Harry-Qu/drone/Doc/飞行状态转换.md

飞行状态转换

| | STOP-INIT | STOP-MANUAL_CALIBRATION |  STOP-READY  |
| --- | :---: | :---: | :---: |
| STOP-INIT | / | (自检异常) \|\| (S1=UP && S2=DOWN) | 完成自检 |
| STOP-MANUAL_CALIBRATION | / | / | 人工校准完成 |
| STOP-READY | / | S1=UP && S2=DOWN | / |
| RUNNING-READY | / | / | S1=UP |
| RUNNING-IDLE | / | / | S1=UP |
| RUNNING-HOVER | / | / | S1=UP |
| RUNNING-MOVING | / | / | S1=UP |

| | RUNNING-READY | RUNNING-IDLE | RUNNING-HOVER | RUNNING-MOVING |
| --- | --- | --- | --- | --- |
| STOP-INIT | / | / | / | / |
| STOP-MANUAL_CALIBRATION | / | / | / | / |
| STOP-READY | S1 = DOWN | / | / | / |
| RUNNING-READY | / | 内八拨杆 | / | / |
| RUNNING-IDLE | / | / | / | 油门向上 |
| RUNNING-HOVER | / | / | / | 拨杆 |
| RUNNING-MOVING | / | / | 摇杆回中 | / |
