Harry-Qu/drone/Code/Core/Src/main.c

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
/* Includes ------------------------------------------------------------------*/
#include "main.h"
#include "dma.h"
#include "i2c.h"
#include "tim.h"
#include "usart.h"
#include "gpio.h"

/* USER CODE BEGIN Includes */
#include "ucos_ii.h"
#include "app_manage.h"
#include "sdk_time.h"
#include "sdk_ano.h"
#include "sdk_i2c.h"
#include "sdk_usart.h"

/* USER CODE END Includes */


void SystemClock_Config(void);
/**
  * @brief  The application entry point.
  * @retval int
  */
int main(void) {
    /* MCU Configuration--------------------------------------------------------*/

    /* Reset of all peripherals, Initializes the Flash interface and the Systick. */
    HAL_Init();

    /* Configure the system clock */
    SystemClock_Config();

    /* Initialize all configured peripherals */
    MX_GPIO_Init();
    MX_DMA_Init();
    MX_USART1_UART_Init();
    MX_TIM3_Init();
    MX_I2C1_Init();
    MX_USART2_UART_Init();
    MX_USART6_UART_Init();
    MX_TIM10_Init();
    MX_I2C3_Init();
    /* USER CODE BEGIN 2 */

    sdk_io_init(FD_UART);
    HAL_Delay(1);


//    app_bluetooth_init();

//    app_oled_Show_Template();

    OS_TRACE_INIT();
    OS_TRACE_START();
    OSInit();

    sdk_i2c_dma_init();
    sdk_usartdma_init();

    app_init();
    app_create_task();


    OSStart();

    /* USER CODE END 2 */

    /* Infinite loop */
    /* USER CODE BEGIN WHILE */

    while (1) {
        /* USER CODE END WHILE */

        /* USER CODE BEGIN 3 */
    }
    /* USER CODE END 3 */
}

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
