Harry-Qu/drone/Code/App/Inc/app_control.h

/** 
 *  @brief	    控制相关任务
 *  @details    提供控制相关任务，包含对遥控器数据解算，计算期望角度，PID计算，动能分配，输出PWM
 *  @author     Harry-Qu
 *  @date       2022/10/28
 *  @version    1.1
 *  @par        日志
 *                  1.0.0   |   实现基本控制功能
 *                  1.0.1   |   新增限制最大转速功能
 *                  1.0.2   |   修改电机转速测试代码中满油门值为限制最大转速值
 *                  1.1     |   新增数据互斥访问功能
*/

#include "main.h"
#include "pid.h"
#include "driver_motor.h"

#ifndef APP_CONTROL_H
#define APP_CONTROL_H

#define MOTOR_FL 2
#define MOTOR_FR 1
#define MOTOR_BR 0
#define MOTOR_BL 3

#define HOVER_MOTOR_SPEED 3400 //悬停时电机转速，3500/10000
#define IDLE_MOTOR_SPEED 800  //怠速时电机速度
#define LIMIT_MOTOR_SPEED 7000 //限制最高转速

#define MAX_ROLL_ANGLE 5.0f    //最大横滚角度（角度制） degree
#define MAX_PITCH_ANGLE 5.0f   //最大俯仰角度（角度制） degree

#define MAX_VERTICAL_SPEED 3.0f      //最大上升速度（m/s）
#define MAX_YAW_SPEED 1.0f     //最大旋转角速度（rad/s）

//  PID参数

#define PID_ROLL_OUTER_KP 0.04f
#define PID_ROLL_OUTER_KI 0.001f
#define PID_ROLL_OUTER_KD 0.03f
#define PID_ROLL_OUTER_INTEGRAL_LIMIT 30.0f

#define PID_ROLL_INNER_KP 1350.0f
#define PID_ROLL_INNER_KI 26.0f
#define PID_ROLL_INNER_KD 800.0f
#define PID_ROLL_INNER_INTEGRAL_LIMIT 18.0f

#define PID_PITCH_OUTER_KP 0.03f
#define PID_PITCH_OUTER_KI 0.001f
#define PID_PITCH_OUTER_KD 0.02f
#define PID_PITCH_OUTER_INTEGRAL_LIMIT 50.0f

#define PID_PITCH_INNER_KP 2630.0f
#define PID_PITCH_INNER_KI 15.0f
#define PID_PITCH_INNER_KD 2500.0f
#define PID_PITCH_INNER_INTEGRAL_LIMIT 20.0f

#define PID_YAW_KP 6500.0f
#define PID_YAW_KI 0.0f
#define PID_YAW_KD 0.0f
#define PID_YAW_INTEGRAL_LIMIT 0.0f

#define PID_HEIGHT_KP 250.0f
#define PID_HEIGHT_KI 0.0f
#define PID_HEIGHT_KD 0.0f
#define PID_HEIGHT_INTEGRAL_LIMIT 0.0f

#if (MAX_MOTOR_SPEED < LIMIT_MOTOR_SPEED)
#error "限制转速必须小于等于最大转速"
#endif

#if (MAX_MOTOR_SPEED < HOVER_MOTOR_SPEED)
#error "悬停转速转速必须小于等于最大转速"
#endif

enum FLY_MODE {
    STOP = 0,   //停桨模式
    RUNNING,    //开桨状态

};

enum FLY_STATE {
    INIT = 0,   // 初始化中
    MANUAL_CALIBRATION,  // 人工校准状态
    READY,      // 就绪状态
    SENSOR_ERROR,

    IDLE,       // 怠速状态
    HOVER,      // 悬停状态
    MOVING      // 运动状态
};

extern pid_type pidRollInner, pidRollOuter, pidPitchInner, pidPitchOuter, pidYaw, pidHeight;

extern float motorSpeed[4];

/**
 * 发送四个电机转速给匿名上位机
 */
void app_control_transmitMotorSpeed(void);

/**
 * 修改飞行模式
 * @details 根据遥控器数据切换状态
 */
void app_control_modifyFlyMode(void);

/**
 * 切换运行状态（仅允许在STOP模式操作）
 * 用于自检阶段切换状态
 * @param state 要切换到的状态
 */
void app_control_toggleFlyState(enum FLY_STATE state);

/**
 * 控制任务
 * @param args
 */
void app_control_task(void *args);

/**
 * 控制初始化
 */
void app_control_init(void);

#endif //APP_CONTROL_H
