Harry-Qu/drone/Code/Ucos/os_trace.h

/*
*********************************************************************************************************
*                                              uC/OS-II
*                                        The Real-Time Kernel
*
*                    Copyright 1992-2021 Silicon Laboratories Inc. www.silabs.com
*
*                                 SPDX-License-Identifier: APACHE-2.0
*
*               This software is subject to an open source license and is distributed by
*                Silicon Laboratories Inc. pursuant to the terms of the Apache License,
*                    Version 2.0 available at www.apache.org/licenses/LICENSE-2.0.
*
*********************************************************************************************************
*/


/*
*********************************************************************************************************
*
*                                             TRACE SUPPORT
*
* Filename : os_trace.h
* Version  : V2.93.01
*********************************************************************************************************
* Note(s) : (1) The header file os_trace_events.h is the interface between uC/OS-II and your trace
*               recorder of choice.
*               To support trace recording, include one of the sub-folders at uCOS-II/Trace/ into
*               your project.
*********************************************************************************************************
*/

#ifndef   OS_TRACE_H
#define   OS_TRACE_H

#include  <os_cfg.h>
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
