Harry-Qu/drone/(commit log)

2022-11-20 新增Makefile Readme文件
2022-11-20 新增人为限制电机转速最大值功能
2022-11-26 新增向I2C设备指定内存地址写入数据功能
2022-11-26 新增MPU6050, HMC5883L, MS5611驱动 拆分GY86驱动
2022-11-26 修改Makefile：新增验证bin文件功能，对是否烧写成功的识别更加准确
2022-11-26 新增从指定页中读写数据的接口driver_at24c0x_writeData_page, driver_at24c0x_readData_page 修改部分接口返回类型为uint8_t
2022-11-26 修改电机转速测试代码中满油门值为限制最大转速值
2022-11-26 新增I2C3与I2C3对应DMA
2022-12-20 新增RGB驱动函数注释
2022-12-22 为EEPROM读写增加数据切片功能，保证读写大量数据时的准确性 修改dataSize参数类型为uint8_t
2022-12-22 取消OLED驱动代码的裁剪性
2022-12-22 修复命名错误
2022-12-22 新增8字校准法，使用EEPROM保存校准数据
2022-12-23 新增I2C总线恢复功能
2022-12-23 修改控制电机PWM占空比
2023-01-05 新增数据互斥访问功能，新增PID调试参数存储功能，修复一些问题
2023-01-06 新增匿名上位机刷新帧功能
2023-01-27 稳定飞行版本
